pabloalcaraz/air-script/webpage_gz.h

#pragma once
#include <Arduino.h>

// GENERADO POR tools/gzip-web.cjs — NO EDITAR A MANO.
// Regenerar con:  node tools/gzip-web.cjs
// Origen: webpage.h (44104 B) -> 16103 B gzip (63% menos).
// Huella del origen (sha256): c2cf30c93a6bebc8065f604016e94f60f840369a07916efaa7e399cec040d789

#define PAGINA_GZ_SHA256 "c2cf30c93a6bebc8065f604016e94f60f840369a07916efaa7e399cec040d789"
#define PAGINA_GZ_LEN 16103

static const uint8_t PAGINA_GZ[] PROGMEM = {
  0x1f,0x8b,0x08,0x00,0x00,0x00,0x00,0x00,0x02,0x0a,0xbd,0xbd,0xdb,0x6e,0x23,0x39,
  0xb6,0x20,0xfa,0xae,0xaf,0x60,0xb1,0xa6,0xd3,0x8a,0x52,0x28,0x2c,0xc9,0x97,0xcc,
  0x92,0x1c,0xf2,0xb8,0x32,0x5d,0x9d,0x89,0xc9,0xdb,0xb6,0xb3,0xaa,0x71,0x4e,0x4e,
  0xa2,0x40,0x45,0xd0,0x12,0xd3,0x11,0xc1,0x48,0x32,0x42,0x69,0x97,0xd3,0x83,0x8d,
  0x79,0xd8,0x6f,0xfb,0x61,0xe6,0x6c,0x9c,0x01,0xe6,0x69,0xfa,0x65,0x80,0xc6,0x41,
  0x01,0x67,0x50,0x38,0xd8,0x40,0x9f,0x87,0x06,0xca,0xef,0xf3,0x11,0xf5,0x25,0x83,
  0xb5,0x48,0xc6,0x45,0x92,0x9d,0xee,0xdb,0x34,0xd0,0x95,0x56,0x04,0xc9,0x20,0x17,
  0x17,0xd7,0x7d,0x2d,0x1e,0x7c,0xf1,0xe4,0xd5,0xe3,0x37,0xff,0xc7,0xeb,0x63,0xb2,
  0x28,0xd2,0x64,0xda,0x39,0x80,0x7f,0x48,0xc2,0xb2,0x79,0x48,0xb9,0xa6,0xf0,0x80,
  0xb3,0x78,0xda,0x39,0x48,0x79,0xc1,0x48,0xb4,0x60,0x4a,0xf3,0x22,0xa4,0x65,0x71,
  0xd6,0x7f,0x44,0xdd,0xe3,0x8c,0xa5,0x3c,0xa4,0x4b,0xc1,0x3f,0xe6,0x52,0x15,0x94,
  0x44,0x32,0x2b,0x78,0x56,0x84,0xf4,0xa3,0x88,0x8b,0x45,0x18,0xf3,0xa5,0x88,0x78,
  0x1f,0x7f,0xf8,0x22,0x13,0x85,0x60,0x49,0x5f,0x47,0x2c,0xe1,0xe1,0x10,0xc6,0x28,
  0x44,0x91,0xf0,0xe9,0x91,0x50,0xe4,0x34,0x52,0x22,0x2f,0x0e,0xb6,0xcd,0x93,0xce,
  0xc1,0x17,0xfd,0x3e,0x79,0x16,0xc9,0x4c,0x92,0x25,0x8b,0x84,0x1c,0x13,0x2d,0x32,
  0xc2,0x75,0x21,0x09,0x4f,0x48,0xc6,0x96,0x7c,0xce,0x62,0xa9,0x48,0x2e,0x62,0x4e,
  0xb6,0xcf,0xd8,0x52,0x44,0x32,0x0b,0x44,0x24,0x09,0xcf,0x48,0xc4,0x62,0x46,0x22,
  0xa6,0xe6,0x8c,0x5c,0x76,0x08,0xfc,0x8f,0x27,0xe4,0xf8,0xf4,0xf5,0xce,0x88,0x68,
  0x4e,0x22,0x99,0x72,0x52,0x66,0x8c,0xe4,0xbc,0x10,0x91,0x90,0x19,0xe1,0x17,0x85,
  0x62,0x24,0x67,0x8a,0x91,0x98,0x2f,0x65,0xb2,0xe4,0x8a,0x94,0x19,0xd9,0x1d,0xec,
  0x06,0xa4,0xdf,0x9f,0x76,0x0e,0x12,0x91,0x9d,0x13,0xc5,0x93,0x90,0xc2,0x67,0x28,
  0x59,0x28,0x7e,0x16,0xd2,0x98,0x15,0x6c,0xec,0xc3,0x32,0x74,0x71,0x09,0x93,0x1e,
  0x2b,0x29,0x8b,0xab,0x0e,0xe9,0xf7,0x67,0xf3,0xf1,0x97,0x03,0x3e,0x1c,0x0e,0xf7,
  0x27,0xfd,0x7e,0xce,0x32,0x9e,0x8c,0xbf,0x1c,0x3e,0x1c,0x46,0xa3,0xdd,0x49,0xbf,
  0x9f,0x88,0x8c,0xb3,0xf1,0x97,0xa3,0xbd,0x51,0xb4,0xf3,0x68,0xd2,0xef,0x17,0x17,
  0xc5,0xf8,0x4b,0xfe,0x88,0x47,0x67,0xa3,0x49,0xbf,0xaf,0xe5,0x59,0x31,0xfe,0xf2,
  0xeb,0x3d,0x36,0x98,0xed,0x4c,0x60,0x2c,0x79,0x3e,0xfe,0x72,0xe7,0x6c,0x36,0x7a,
  0x78,0x36,0xe9,0xf7,0xd9,0x52,0x68,0x39,0xfe,0x92,0x0f,0xd8,0xce,0x0e,0x9f,0xf4,
  0xfb,0x29,0x4b,0xe0,0xe7,0x68,0x6f,0x7f,0x37,0x86,0xd7,0x3f,0x96,0xc9,0xf8,0xcb,
  0x3d,0xc6,0xbe,0xe6,0xfb,0x93,0xce,0x75,0xe7,0xab,0xab,0x99,0xbc,0xe8,0x6b,0xf1,
  0xa3,0xc8,0xe6,0xe3,0x99,0x54,0x31,0x57,0xfd,0x99,0xbc,0xb8,0xee,0xcc,0x64,0x7c,
  0x79,0x95,0x32,0x35,0x17,0xd9,0x78,0x30,0x99,0xb1,0xe8,0x7c,0xae,0x64,0x99,0xc5,
  0xe3,0x25,0x53,0x5d,0x98,0xbf,0x37,0x89,0x64,0x22,0x95,0xfd,0x5d,0x5c,0x14,0xde,
  0xa4,0x43,0xce,0x64,0x56,0x8c,0x87,0xfb,0xf9,0xc5,0xf6,0x30,0xd8,0xdd,0x23,0xfa,
  0x52,0x17,0x3c,0xed,0x97,0xc2,0xef,0xb3,0x3c,0x4f,0x78,0xdf,0x3c,0xf0,0xe9,0x29,
  0x9f,0x4b,0x4e,0xbe,0x7b,0x46,0xfd,0x13,0x39,0x93,0x85,0xf4,0x35,0xcb,0x74,0x5f,
  0x73,0x25,0xce,0xae,0x3b,0x80,0x55,0x5c,0x5d,0xe5,0x2c,0x8e,0x61,0x56,0x30,0x1c,
  0x19,0x3e,0x82,0xff,0x0c,0xf2,0x8b,0x49,0x35,0xc9,0xa2,0x90,0xe9,0x78,0x98,0x5f,
  0x10,0x2d,0x13,0x11,0x13,0x33,0x0f,0x04,0x9d,0x77,0xdd,0x59,0x0c,0xeb,0xc9,0xc3,
  0xa4,0x60,0x89,0x7c,0x3c,0xdc,0xcb,0x2f,0x26,0x09,0x2f,0x0a,0xae,0xfa,0x3a,0x67,
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
};
