pabloalcaraz/air-script/outdoor_ca.h

#pragma once

// ISRG Root X1, raiz de Let's Encrypt usada por AQICN y Open-Meteo. Certificado
// publico oficial de https://letsencrypt.org/certificates/, valido hasta
// 2035-06-04. Ojo con la fecha que importa de verdad: desde 2026 la cadena
// servida pasa por ISRG Root YR, cross-firmada por X1, y ESE cross-sign vence
// el 2032-09-02. Cuando Let's Encrypt deje de servirlo, este pin dejara de
// validar aunque X1 siga en fecha.
static const char OUTDOOR_ROOT_CA[] PROGMEM = R"CERT(
-----BEGIN CERTIFICATE-----
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
-----END CERTIFICATE-----
)CERT";
