pabloalcaraz/air-script/cloud_ca.h

#pragma once

// DigiCert Global Root G2, raiz que valida los endpoints de ingesta de
// Grafana Cloud (*.grafana.net) a fecha de 2026-08. Certificado publico,
// descargado de https://cacerts.digicert.com/DigiCertGlobalRootG2.crt.pem
// y valido hasta 2038-01-15.
static const char CLOUD_ROOT_CA[] PROGMEM = R"CERT(
-----BEGIN CERTIFICATE-----
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
MrY=
-----END CERTIFICATE-----
)CERT";
