pabloalcaraz/air-script/(commit log)

2026-08-18 Fix PM alerts and harden firmware transport
    [air-script.ino, alerts.cpp, cloud.cpp, cloud.h, config.h, eventlog.cpp, eventlog.h]
2026-09-18 Update README with images and hardware setup note
    Added images and a note to consult HARDWARE.md for wiring and setup details.
2026-09-18 Corregir el inicio rapido: la carpeta del sketch debe llamarse air-script
    Arduino exige que el directorio coincida con el nombre del .ino principal,
    asi que clonar el repo con su nombre antiguo rompia el primer compile que
    intentaba cualquier recien llegado.
2026-09-18 Alinear la documentacion con lo que hace hoy el firmware
    La fecha de caducidad del pin TLS, el tamano del binario, la version de
    arduino-cli probada y los bordes de los umbrales habian quedado desfasados,
    y /api/stats publicaba un campo que no estaba documentado.
2026-09-18 Quitar el condicional de SECURITY.md ahora que el reporte privado esta activo
    El texto decia 'cuando el repositorio sea publico', pero Private
    Vulnerability Reporting ya esta habilitado en GitHub: el boton que promete
    el documento existe de verdad.
2026-09-18 Quitar los caracteres no ASCII de las fuentes del firmware
    El separador del mensaje de arranque de AQICN salia como basura en el monitor
    serie, que usa CP437; los comentarios con tildes se limpian de paso para que
    la regla de CONTRIBUTING se cumpla de verdad.
2026-09-18 Servir las imagenes del README desde el propio repositorio
    Estaban alojadas como adjuntos de GitHub: un fork o un clone se quedaba sin
    ellas, y las dos fotos venian a 4032 px de ancho. De paso, los textos alt
    pasan a describir lo que se ve.
2026-09-18 Anadir badge de CI, plantillas de issue/PR y guia de contribucion
    El repo se abre al publico sin decir en ninguna parte como reportar un fallo
    ni que hace falta para que un PR sea revisable, y las plantillas recuerdan lo
    que mas se olvida: la validacion en hardware y no pegar credenciales.
